TheOnlyMiki/CSEE-4840-N-Body/Software/accelerator_driver.c

/*
 * N-body Avalon-MM Linux driver.
 *
 * This follows nbody_accel_avmm.sv exactly. Register addresses below are
 * byte offsets for ioread32/iowrite32; the hardware Avalon address is a
 * 32-bit word address, so every register is word_address * 4.
 */

#include <linux/errno.h>
#include <linux/fs.h>
#include <linux/init.h>
#include <linux/io.h>
#include <linux/kernel.h>
#include <linux/miscdevice.h>
#include <linux/module.h>
#include <linux/of.h>
#include <linux/of_address.h>
#include <linux/platform_device.h>
#include <linux/slab.h>
#include <linux/string.h>
#include <linux/uaccess.h>
#include "nbody_ioctl.h"

#define DRIVER_NAME "nbody"

#define REG_GO        (0x00 * 4)
#define REG_N_BODIES  (0x01 * 4)
#define REG_GAP       (0x02 * 4)
#define REG_X_IN      (0x03 * 4)
#define REG_Y_IN      (0x04 * 4)
#define REG_M_IN      (0x05 * 4)
#define REG_VX_IN     (0x06 * 4)
#define REG_VY_IN     (0x07 * 4)
#define REG_DONE      (0x08 * 4)
#define REG_READ      (0x09 * 4)
#define REG_OUT_X     (0x0A * 4)
#define REG_OUT_Y     (0x0B * 4)

struct nbody_dev {
    struct resource res;
    void __iomem *virtbase;
    uint32_t num_bodies;
    uint32_t gap;
};

static struct nbody_dev dev;

/*
 * Convert a userspace IEEE-754 single-precision float into the accelerator's
 * custom S1E8M18 27-bit floating-point format.
 *
 * The converted value is stored in the lower 27 bits of a 32-bit Avalon word.
 * The upper 5 bits are unused padding.
 */
static uint32_t f32_to_f27_bits(const float *value)
{
    uint32_t bits;
    uint32_t sign;
    uint32_t exp;
    uint32_t mant;
    uint32_t rounded_mant;

    memcpy(&bits, value, sizeof(bits));

    sign = (bits >> 31) & 1u;
    exp = (bits >> 23) & 0xffu;
    mant = bits & 0x007fffffu;

    if (exp == 0)
        return 0;
    if (exp == 0xffu)
        return (sign << NBODY_F27_SIGN_SHIFT) | (0xfeu << NBODY_F27_EXP_SHIFT) |
               NBODY_F27_MANT_MASK;

    rounded_mant = (mant + 0x10u) >> 5;
    if (rounded_mant == (1u << 18)) {
        rounded_mant = 0;
        exp++;
        if (exp >= 0xffu) {
            exp = 0xfeu;
            rounded_mant = NBODY_F27_MANT_MASK;
        }
    }

    return (sign << NBODY_F27_SIGN_SHIFT) |
           (exp << NBODY_F27_EXP_SHIFT) |
           (rounded_mant & NBODY_F27_MANT_MASK);
}

/*
 * Convert a raw 27-bit S1E8M18 hardware result back into an IEEE-754
 * single-precision float for userspace.
 */
static void f27_bits_to_f32(uint32_t raw, float *value)
{
    uint32_t bits;
    uint32_t sign;
    uint32_t exp;
    uint32_t mant;

    raw &= NBODY_DATA_MASK;
    if (raw == 0) {
        bits = 0;
    } else {
        sign = (raw >> NBODY_F27_SIGN_SHIFT) & 1u;
        exp = (raw >> NBODY_F27_EXP_SHIFT) & 0xffu;
        mant = raw & NBODY_F27_MANT_MASK;

        if (exp == 0) {
            bits = 0;
        } else {
            bits = (sign << 31) | (exp << 23) | (mant << 5);
        }
    }

    memcpy(value, &bits, sizeof(bits));
}

/*
 * Copy the initial particle array from userspace, convert each field from
 * float32 to S1E8M18, and stream the data into the hardware input registers.
 *
 * The hardware commits one complete body when VY_IN is written, so the fields
 * must be written in the expected X, Y, mass, VX, VY order.
 */
static int nbody_write_bodies(unsigned long arg)
{
    nbody_bodies_arg_t barg;
    nbody_particle_t *particles;
    size_t bytes;
    uint32_t i;

    if (copy_from_user(&barg, (void __user *)arg, sizeof(barg)))
        return -EFAULT;

    if (barg.count == 0 || barg.count > NBODY_MAX_BODIES || !barg.particles)
        return -EINVAL;

    if (dev.num_bodies == 0 || barg.count != dev.num_bodies)
        return -EINVAL;

    bytes = barg.count * sizeof(*particles);
    particles = memdup_user((const void __user *)barg.particles, bytes);
    if (IS_ERR(particles))
        return PTR_ERR(particles);

    /*
     * Userspace passes IEEE-754 single-precision values. Hardware payloads are
     * rounded to S1E8M18 in the low 27 bits of each 32-bit Avalon word; the
     * upper 5 bits are zero padding. Writing VY_IN commits the current body
     * and advances input_ptr.
     */
    for (i = 0; i < barg.count; i++) {
        iowrite32(f32_to_f27_bits(&particles[i].x), dev.virtbase + REG_X_IN);
        iowrite32(f32_to_f27_bits(&particles[i].y), dev.virtbase + REG_Y_IN);
        iowrite32(f32_to_f27_bits(&particles[i].mass), dev.virtbase + REG_M_IN);
        iowrite32(f32_to_f27_bits(&particles[i].vx), dev.virtbase + REG_VX_IN);
        iowrite32(f32_to_f27_bits(&particles[i].vy), dev.virtbase + REG_VY_IN);
    }

    kfree(particles);
    return 0;
}

/*
 * Read computed body positions from the accelerator output registers.
 *
 * Writing READ=1 prepares the hardware output stream. For each body, OUT_X is
 * read first and OUT_Y is read second. The hardware output pointer advances
 * only after OUT_Y is read.
 */
static int nbody_read_results(unsigned long arg)
{
    nbody_read_arg_t rarg;
    nbody_result_t *results;
    size_t bytes;
    uint32_t i;
    int ret = 0;

    if (copy_from_user(&rarg, (void __user *)arg, sizeof(rarg)))
        return -EFAULT;

    if (rarg.count == 0 || rarg.count > NBODY_MAX_BODIES ||
        rarg.count > dev.num_bodies || !rarg.results)
        return -EINVAL;

    bytes = rarg.count * sizeof(*results);
    results = kmalloc(bytes, GFP_KERNEL);
    if (!results)
        return -ENOMEM;

    iowrite32(1, dev.virtbase + REG_READ);

    /*
     * Read OUT_X first, then OUT_Y. Only the OUT_Y read increments the
     * hardware output pointer.
     */
    for (i = 0; i < rarg.count; i++) {
        f27_bits_to_f32(ioread32(dev.virtbase + REG_OUT_X), &results[i].x);
        f27_bits_to_f32(ioread32(dev.virtbase + REG_OUT_Y), &results[i].y);
    }

    if (copy_to_user((void __user *)rarg.results, results, bytes))
        ret = -EFAULT;

    kfree(results);
    return ret;
}

/*
 * Main ioctl dispatch function for /dev/nbody.
 *
 * Each command corresponds to one userspace accelerator operation, such as
 * writing configuration, loading input bodies, starting a run, checking DONE,
 * reading output positions, or clearing the hardware read state.
 */
static long nbody_ioctl(struct file *f, unsigned int cmd, unsigned long arg)
{
    nbody_config_t cfg;
    int done;

    switch (cmd) {
    case NBODY_WRITE_CONFIG:
        if (copy_from_user(&cfg, (void __user *)arg, sizeof(cfg)))
            return -EFAULT;
        if (cfg.num_bodies > NBODY_MAX_BODIES || cfg.gap == 0)
            return -EINVAL;

        dev.num_bodies = cfg.num_bodies;
        dev.gap = cfg.gap;
        iowrite32(cfg.num_bodies, dev.virtbase + REG_N_BODIES);
        iowrite32(cfg.gap, dev.virtbase + REG_GAP);
        return 0;

    case NBODY_WRITE_BODIES:
        return nbody_write_bodies(arg);

    case NBODY_START_RUN:
        iowrite32(1, dev.virtbase + REG_GO);
        return 0;

    case NBODY_CHECK_DONE:
        done = ioread32(dev.virtbase + REG_DONE) & 1;
        if (copy_to_user((int __user *)arg, &done, sizeof(done)))
            return -EFAULT;
        return 0;

    case NBODY_READ_RESULTS:
        return nbody_read_results(arg);

    case NBODY_CLEAR_READ:
        iowrite32(0, dev.virtbase + REG_READ);
        return 0;

    case NBODY_STOP:
        /* GO is pulse-based in SV; best-effort stop is clearing READ. */
        iowrite32(0, dev.virtbase + REG_READ);
        return 0;

    case NBODY_SOFT_RESET:
        /*
         * There is no full software reset register. Clear READ/output_ptr;
         * userspace must reload config and bodies for a fresh simulation.
         */
        iowrite32(0, dev.virtbase + REG_READ);
        return 0;

    default:
        return -EINVAL;
    }
}

static const struct file_operations nbody_fops = {
    .owner = THIS_MODULE,
    .unlocked_ioctl = nbody_ioctl,
};

static struct miscdevice nbody_misc_device = {
    .minor = MISC_DYNAMIC_MINOR,
    .name = "nbody",
    .fops = &nbody_fops,
};

/*
 * Platform driver probe function.
 *
 * This function is called when the matching device-tree node is found. It maps
 * the accelerator register space, registers /dev/nbody as a misc device, and
 * initializes basic hardware control registers.
 */
static int nbody_probe(struct platform_device *pdev)
{
    int ret;

    ret = of_address_to_resource(pdev->dev.of_node, 0, &dev.res);
    if (ret)
        return ret;

    if (!request_mem_region(dev.res.start, resource_size(&dev.res), DRIVER_NAME))
        return -EBUSY;

    dev.virtbase = of_iomap(pdev->dev.of_node, 0);
    if (!dev.virtbase) {
        ret = -ENOMEM;
        goto out_release;
    }

    ret = misc_register(&nbody_misc_device);
    if (ret)
        goto out_unmap;

    iowrite32(0, dev.virtbase + REG_READ);
    iowrite32(1, dev.virtbase + REG_GAP);
    pr_info("nbody driver registered /dev/nbody\n");
    return 0;

out_unmap:
    iounmap(dev.virtbase);
out_release:
    release_mem_region(dev.res.start, resource_size(&dev.res));
    return ret;
}

/*
 * Platform driver remove function.
 *
 * Release the misc device, unmap the hardware register space, and free the
 * reserved memory region.
 */
static int nbody_remove(struct platform_device *pdev)
{
    misc_deregister(&nbody_misc_device);
    if (dev.virtbase)
        iounmap(dev.virtbase);
    release_mem_region(dev.res.start, resource_size(&dev.res));
    return 0;
}

static const struct of_device_id nbody_of_match[] = {
    { .compatible = "csee4840,nbody_accel_avmm-1.0" },
    {},
};
MODULE_DEVICE_TABLE(of, nbody_of_match);

static struct platform_driver nbody_driver = {
    .probe = nbody_probe,
    .remove = nbody_remove,
    .driver = {
        .name = DRIVER_NAME,
        .of_match_table = nbody_of_match,
    },
};

module_platform_driver(nbody_driver);

MODULE_LICENSE("GPL");
MODULE_AUTHOR("CSEE4840 Group");
MODULE_DESCRIPTION("N-body Avalon-MM accelerator driver");
