TheOnlyMiki/CSEE-4840-N-Body/Software/display.c

#include <ctype.h>
#include <fcntl.h>
#include <stdint.h>
#include <stdio.h>
#include <stdlib.h>
#include <string.h>
#include <sys/ioctl.h>
#include <unistd.h>

#include "display.h"
#include "nbody.h"

static int display_fd = -1;
static uint32_t framebuffer[DISPLAY_WORDS];
static uint8_t body_masks[NUM_BODY_RADII][9][9];

static const int BODY_RADII[NUM_BODY_RADII] = { 1, 2, 3, 4 };

// Set a specific pixel is on or off (1/0)
static inline void set_pixel(int x, int y, int on)
{
    // Check if the coordinates are out of bounds
    if (x < 0 || x >= DISPLAY_WIDTH || y < 0 || y >= DISPLAY_HEIGHT)
        return;

    /*
    Packed display format
    frame index = y * 20 + x / 32, bit = x & 31 (x % 32)
    one LSB-first bit per pixel
    */
    if (on) {
        framebuffer[y * DISPLAY_WORDS_PER_ROW + x / 32] |= (1u << (x & 31));
    } else {
        framebuffer[y * DISPLAY_WORDS_PER_ROW + x / 32] &= ~(1u << (x & 31));
    }
}

// Returning the 5-bit character set of a given character in a given line
static uint8_t glyph_row(char c, int row)
{
    // Each character consists of 7 rows, with each row represented by 5 bits
    static const uint8_t blank[7] = { 0, 0, 0, 0, 0, 0, 0 };
    static const uint8_t glyphs[][7] = {
        ['0'] = { 0x0e, 0x11, 0x13, 0x15, 0x19, 0x11, 0x0e },
        ['1'] = { 0x04, 0x0c, 0x04, 0x04, 0x04, 0x04, 0x0e },
        ['2'] = { 0x0e, 0x11, 0x01, 0x02, 0x04, 0x08, 0x1f },
        ['3'] = { 0x1e, 0x01, 0x01, 0x0e, 0x01, 0x01, 0x1e },
        ['4'] = { 0x02, 0x06, 0x0a, 0x12, 0x1f, 0x02, 0x02 },
        ['5'] = { 0x1f, 0x10, 0x10, 0x1e, 0x01, 0x01, 0x1e },
        ['6'] = { 0x0e, 0x10, 0x10, 0x1e, 0x11, 0x11, 0x0e },
        ['7'] = { 0x1f, 0x01, 0x02, 0x04, 0x08, 0x08, 0x08 },
        ['8'] = { 0x0e, 0x11, 0x11, 0x0e, 0x11, 0x11, 0x0e },
        ['9'] = { 0x0e, 0x11, 0x11, 0x0f, 0x01, 0x01, 0x0e },
        ['A'] = { 0x0e, 0x11, 0x11, 0x1f, 0x11, 0x11, 0x11 },
        ['B'] = { 0x1e, 0x11, 0x11, 0x1e, 0x11, 0x11, 0x1e },
        ['C'] = { 0x0f, 0x10, 0x10, 0x10, 0x10, 0x10, 0x0f },
        ['D'] = { 0x1e, 0x11, 0x11, 0x11, 0x11, 0x11, 0x1e },
        ['E'] = { 0x1f, 0x10, 0x10, 0x1e, 0x10, 0x10, 0x1f },
        ['F'] = { 0x1f, 0x10, 0x10, 0x1e, 0x10, 0x10, 0x10 },
        ['G'] = { 0x0f, 0x10, 0x10, 0x13, 0x11, 0x11, 0x0f },
        ['H'] = { 0x11, 0x11, 0x11, 0x1f, 0x11, 0x11, 0x11 },
        ['I'] = { 0x0e, 0x04, 0x04, 0x04, 0x04, 0x04, 0x0e },
        ['J'] = { 0x07, 0x02, 0x02, 0x02, 0x12, 0x12, 0x0c },
        ['K'] = { 0x11, 0x12, 0x14, 0x18, 0x14, 0x12, 0x11 },
        ['L'] = { 0x10, 0x10, 0x10, 0x10, 0x10, 0x10, 0x1f },
        ['M'] = { 0x11, 0x1b, 0x15, 0x15, 0x11, 0x11, 0x11 },
        ['N'] = { 0x11, 0x19, 0x15, 0x13, 0x11, 0x11, 0x11 },
        ['O'] = { 0x0e, 0x11, 0x11, 0x11, 0x11, 0x11, 0x0e },
        ['P'] = { 0x1e, 0x11, 0x11, 0x1e, 0x10, 0x10, 0x10 },
        ['Q'] = { 0x0e, 0x11, 0x11, 0x11, 0x15, 0x12, 0x0d },
        ['R'] = { 0x1e, 0x11, 0x11, 0x1e, 0x14, 0x12, 0x11 },
        ['S'] = { 0x0f, 0x10, 0x10, 0x0e, 0x01, 0x01, 0x1e },
        ['T'] = { 0x1f, 0x04, 0x04, 0x04, 0x04, 0x04, 0x04 },
        ['U'] = { 0x11, 0x11, 0x11, 0x11, 0x11, 0x11, 0x0e },
        ['V'] = { 0x11, 0x11, 0x11, 0x11, 0x11, 0x0a, 0x04 },
        ['W'] = { 0x11, 0x11, 0x11, 0x15, 0x15, 0x15, 0x0a },
        ['X'] = { 0x11, 0x11, 0x0a, 0x04, 0x0a, 0x11, 0x11 },
        ['Y'] = { 0x11, 0x11, 0x0a, 0x04, 0x04, 0x04, 0x04 },
        ['Z'] = { 0x1f, 0x01, 0x02, 0x04, 0x08, 0x10, 0x1f },
        [':'] = { 0x00, 0x04, 0x04, 0x00, 0x04, 0x04, 0x00 },
        ['/'] = { 0x01, 0x01, 0x02, 0x04, 0x08, 0x10, 0x10 },
        ['['] = { 0x0e, 0x08, 0x08, 0x08, 0x08, 0x08, 0x0e },
        [']'] = { 0x0e, 0x02, 0x02, 0x02, 0x02, 0x02, 0x0e },
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
    };
    const uint8_t *g;

    // Converts lowercase letters to uppercase
    if (c >= 'a' && c <= 'z')
        c = (char)toupper((unsigned char)c);

    // If the character is not supported, display a blank space
    if ((unsigned char) c >= sizeof(glyphs) / sizeof(glyphs[0])) {
        g = blank;
    } else {
        g = glyphs[(unsigned char) c];
    }

    return g[row];
}

// Convert the simulation's world coordinates into screen pixel coordinates
int world_to_screen_x(float x)
{
    float normalized = (x - NBODY_POS_MIN) / (NBODY_POS_MAX - NBODY_POS_MIN);
    return (int) (normalized * (float)(BODY_DISPLAY_W - 1) + 0.5f);
}

// Convert the simulation's world coordinates into screen pixel coordinates
int world_to_screen_y(float y)
{
    float normalized = (y - NBODY_POS_MIN) / (NBODY_POS_MAX - NBODY_POS_MIN);
    return (int) (normalized * (float)(BODY_DISPLAY_H - 1) + 0.5f);
}

// Clear the entire framebuffer to 0, resulting in a black screen
void display_clear(void)
{
    memset(framebuffer, 0, sizeof(framebuffer));
}

/*
The rendering thread needs to draw numerous bodies in every frame
Recalculating the circular geometry each time a body is drawn is time-consuming
Instead, pre-generate the masks beforehand
then simply perform a direct lookup when rendering
*/
void display_init_bodyshape(void)
{
    memset(body_masks, 0, sizeof(body_masks));

    for (int i = 0; i < NUM_BODY_RADII; i++) {
        int r = BODY_RADII[i];
        for (int y = -r; y <= r; y++)
            for (int x = -r; x <= r; x++)
                if (x * x + y * y < r * r + r)
                    body_masks[i][y + r][x + r] = 1;
    }
}

// Draw a body at position (cx, cy)
void display_draw_body(int cx, int cy, int radius_idx)
{
    int r = BODY_RADII[radius_idx];
    for (int y = -r; y <= r; y++) {
        int sy = cy + y;

        // Check if the coordinates are out of bounds
        if (sy < 0 || sy >= BODY_DISPLAY_H)
            continue;
        for (int x = -r; x <= r; x++)
            if (body_masks[radius_idx][y + r][x + r])
                set_pixel(cx + x, sy, 1);
    }
}

// Draw a character at a specific row and column within a text grid
void display_putchar(char c, int row, int col)
{
    // Check if the coordinates are out of bounds
    if (row < 0 || row >= TEXT_ROWS || col < 0 || col >= TEXT_COLS)
        return;

    // Render 5 x 7 character to 8 × 16 pixels
    for (int y = 0; y < FONT_HEIGHT; y++) {
        uint8_t bits = 0;

        if (y >= 2 && y < 16)
            bits = glyph_row(c, (y - 2) / 2);

        for (int x = 0; x < FONT_WIDTH; x++) {
            int on = (x >= 1 && x <= 5) && (bits & (1u << (5 - x)));
            set_pixel(col * FONT_WIDTH + x, row * FONT_HEIGHT + y, on);
        }
    }
}

// Draw Strings Continuously
void display_puts(const char *s, int row, int col)
{
    while (*s && col < TEXT_COLS) {
        display_putchar(*s++, row, col++);
    }
}

// Send the software framebuffer to the kernel driver
// If /dev/nbody_display is not open, return -1
int display_present(void)
{
    if (display_fd < 0)
        return -1;
    return ioctl(display_fd, DISPLAY_WRITE_FRAME, framebuffer);
}

// Display Thread
void *display_thread(void *arg)
{
    // It is merely there to avoid a compiler warning
    (void) arg;

    // Allocate a temporary array to store the positions of the current frame
    body_pos_t *render_positions = malloc(MAX_BODIES * sizeof(*render_positions));
    if (!render_positions)
        return NULL;

    // Open display device
    display_fd = open("/dev/nbody_display", O_RDWR);
    if (display_fd < 0)
        perror("open /dev/nbody_display");

    // Initialize circular mask for the body
    display_init_bodyshape();

    while (running) {
        // Copy a local variables from the global variables
        pthread_mutex_lock(&state_mutex);
        int local_num = num_bodies;
        int local_gap = current_gap;
        int local_count = h_count;
        int local_view = view_idx;
        int local_paused = is_paused;

        // Select the current frame to be displayed from history frames
        if (local_count > 0) {
            int slot = (local_count < MAX_HISTORY) ? local_view : (h_head + local_view) & (MAX_HISTORY - 1);
            memcpy(render_positions, history[slot], local_num * sizeof(*render_positions));
        }
        pthread_mutex_unlock(&state_mutex);

        // Clear the display framebuffer
        display_clear();

        // If historical frames exist
        if (local_count > 0) {
            for (int i = 0; i < local_num; i++) {
                // Retrieve world x/y coordinates and convert to screen x/y coordinates
                int x = world_to_screen_x(render_positions[i].x);
                int y = world_to_screen_y(render_positions[i].y);
                display_draw_body(x, y, (int)static_masses[i]);
            }
        }

        // Display the UI in last two rows in screen/VGA
        char line1[TEXT_COLS + 1];
        snprintf(line1, sizeof(line1), "Bodies: %4d/%d | Gap: %2d/%d | Frame: %d/%d | Status: %s",
                 local_num, MAX_BODIES, local_gap, NBODY_GAP_MAX, local_view + 1, local_count,
                 local_paused ? "PAUSED" : "RUNNING");
        display_puts(line1, UI_START_ROW, 0);
        display_puts("[SPACE] Play/Pause | [W/S] Gap | [A/D] Frame | [R] Reset | [Q] Exit",
                     UI_START_ROW + 1, 0);
        
        // Write the entire framebuffer to the display hardware
        display_present();

        // It sleeps for 33.333 ms, the display thread is running at approximately 30 fps
        usleep(33333);
    }

    // Clear the screen once before exiting and close the display device
    if (display_fd >= 0) {
        display_clear();
        display_present();
        close(display_fd);
        display_fd = -1;
    }

    // Release temporary array
    free(render_positions);

    return NULL;
}
