TheOnlyMiki/CSEE-4840-N-Body/Hardware/tb/tb_core_accel.sv

`timescale 1ns/1ps

//------------------------------------------------------------------------------
// TB: multi-body streaming scheduler driving a 2-body core
// - Reads frame0 file:  idx px py vx vy m   (all hex, S1E8M18 for px/py/vx/vy/m)
// - Streams all pairs (b1 accumulates contributions from every b2!=b1)
// - Core interface:
//     inputs: 27-bit S1E8M18 (pos/mass), prev accel: 27-bit S1E8M18
//     outputs: 27-bit S1E8M18
// - Core has fixed epsilon_square internally 

module tb_core_accel;

  // -----------------------------
  // User knobs
  // -----------------------------
  localparam int N_BODIES  = 1024;   // <-- set any N you want
  localparam int PIPE_LAT  = 18;
  parameter  int PREV_LAT  = 16;

  localparam string INPUT_FILE = "tb/frame_input/frame0_1024binit200_27bits.txt";
  localparam string OUT_FILE_27bits = "tb/output/eps025_accel_27bits_1024binit200.txt";

  logic        i_clk;
  logic        i_rst;  // active-low reset

  logic [26:0] i_b1_x, i_b1_y;
  logic [26:0] i_b2_x, i_b2_y;
  logic [26:0] i_m_b2;

  wire  [26:0] i_a_b1_x, i_a_b1_y;       // 27-bit prev accel, late-aligned
  wire  [26:0] o_a_b1_x, o_a_b1_y;       // 27-bit DUT accel out

  two_body_core dut (
    .i_clk    (i_clk),
    .i_rst    (i_rst),

    .i_b1_x   (i_b1_x),
    .i_b1_y   (i_b1_y),
    .i_b2_x   (i_b2_x),
    .i_b2_y   (i_b2_y),
    .i_m_b2   (i_m_b2),

    .i_a_b1_x (i_a_b1_x),
    .i_a_b1_y (i_a_b1_y),

    .o_a_b1_x (o_a_b1_x),
    .o_a_b1_y (o_a_b1_y)
  );

  // Clock
  initial i_clk = 1'b0;
  always #5 i_clk = ~i_clk; // 100MHz

  // Frame storage
  logic [26:0] px [0:N_BODIES-1];
  logic [26:0] py [0:N_BODIES-1];
  logic [26:0] m  [0:N_BODIES-1];



  // Streaming control
  logic in_valid;
  logic [PIPE_LAT-1:0] vsh;
  logic out_valid;
  assign out_valid = vsh[PIPE_LAT-1];

  logic [26:0] launch_prev_x_27, launch_prev_y_27;
  logic [26:0] prev_x_pipe [0:PREV_LAT-1];
  logic [26:0] prev_y_pipe [0:PREV_LAT-1];

  always_ff @(posedge i_clk) begin
    if (!i_rst) begin
      vsh <= '0;
      for (int p = 0; p < PREV_LAT; p++) begin
        prev_x_pipe[p] <= 27'd0;
        prev_y_pipe[p] <= 27'd0;
      end
    end else begin
      vsh <= {vsh[PIPE_LAT-2:0], in_valid};

      prev_x_pipe[0] <= in_valid ? launch_prev_x_27 : 27'd0;
      prev_y_pipe[0] <= in_valid ? launch_prev_y_27 : 27'd0;
      for (int p = 0; p < PREV_LAT-1; p++) begin
        prev_x_pipe[p+1] <= prev_x_pipe[p];
        prev_y_pipe[p+1] <= prev_y_pipe[p];
      end
    end
  end

  assign i_a_b1_x = prev_x_pipe[PREV_LAT-1];
  assign i_a_b1_y = prev_y_pipe[PREV_LAT-1];

  // Helper tasks for driving input and reading frame files
  task automatic drive_idle();
    begin
      i_b1_x   <= 27'h1FC0000;
      i_b1_y   <= 27'h0000000;
      i_b2_x   <= 27'h2000000;
      i_b2_y   <= 27'h0000000;
      i_m_b2   <= 27'h1FC0000;

      launch_prev_x_27 <= 27'd0;
      launch_prev_y_27 <= 27'd0;

      in_valid <= 1'b0;
    end
  endtask

  // Helper task to drive one transaction (one pair of bodies, plus prev accel)
  task automatic drive_txn(
    input int b1,
    input int b2,
    input logic [26:0] a_prev_x_27,
    input logic [26:0] a_prev_y_27
  );
    begin
      i_b1_x   <= px[b1];
      i_b1_y   <= py[b1];
      i_b2_x   <= px[b2];
      i_b2_y   <= py[b2];
      i_m_b2   <= m[b2];

      launch_prev_x_27 <= a_prev_x_27;
      launch_prev_y_27 <= a_prev_y_27;

      in_valid <= 1'b1;
    end
  endtask

  // Read input frame file
  // line format: idx px py vx vy m (hex)
  task automatic read_frame_file(input string fname);
    int fd;
    string line;
    int idx;
    logic [26:0] lpx, lpy, lvx, lvy, lm;
    int got;
    begin
      for (int t = 0; t < N_BODIES; t++) begin
        px[t] = 27'h0000000;
        py[t] = 27'h0000000;
        m[t]  = 27'h0000000;
      end

      fd = $fopen(fname, "r");
      if (fd == 0) $fatal(1, "ERROR: cannot open INPUT_FILE=%s", fname);

      while (!$feof(fd)) begin
        line = "";
        void'($fgets(line, fd));

        if (line.len() == 0) continue;
        if (line.substr(0,0) == "#") continue;

        got = $sscanf(line, "%d %h %h %h %h %h",
                      idx, lpx, lpy, lvx, lvy, lm);

        if (got == 6 && idx >= 0 && idx < N_BODIES) begin
          px[idx] = lpx;
          py[idx] = lpy;
          m[idx]  = lm;
        end
      end
      $fclose(fd);
    end
  endtask

  // Auto-alignment queue (tracks which txn produced each output)
  typedef struct packed {
    int b1;
    int b2;
  } txn_t;

  txn_t q[$];

  // Scheduling state
  // We keep per-b1 running accel in 27-bit (as the core output is "prev+term")
  // busy[b1] prevents issuing next (b1, b2) until previous output for b1 returns.
  logic [26:0] a_acc_x_27 [0:N_BODIES-1];
  logic [26:0] a_acc_y_27 [0:N_BODIES-1];
  logic        busy       [0:N_BODIES-1];
  int          next_j     [0:N_BODIES-1];

  function automatic int pick_b1();
    int b;
    begin
      pick_b1 = -1;
      for (b = 0; b < N_BODIES; b++) begin
        if (!busy[b]) begin
          // skip self-pair
          while (next_j[b] < N_BODIES && next_j[b] == b) next_j[b]++;
          if (next_j[b] < N_BODIES) begin
            pick_b1 = b;
            return pick_b1;
          end
        end
      end
    end
  endfunction

  function automatic bit all_done();
    int b;
    begin
      all_done = 1'b1;
      for (b = 0; b < N_BODIES; b++) begin
        int tmp;
        tmp = next_j[b];
        while (tmp < N_BODIES && tmp == b) tmp++;
        if (tmp < N_BODIES) all_done = 1'b0;
        if (busy[b])        all_done = 1'b0;
      end
      if (q.size() != 0) all_done = 1'b0;
      if (vsh != '0)     all_done = 1'b0;
    end
  endfunction

  integer fo;
  integer b;
  integer b1;
  integer b2;

  initial begin
    drive_idle();

    // reset (active-low)
    i_rst = 1'b0;
    repeat (5) @(posedge i_clk);
    i_rst = 1'b1;
    repeat (5) @(posedge i_clk);

    read_frame_file(INPUT_FILE);

    // init per-body accumulators and sched
    for (b = 0; b < N_BODIES; b++) begin
      a_acc_x_27[b] = 27'd0;
      a_acc_y_27[b] = 27'd0;
      busy[b]       = 1'b0;
      next_j[b]     = 0;
    end

    // streaming loop
    while (!all_done()) begin
      @(posedge i_clk); #1;

      // 1) receive aligned output (27-bit), update per-b1 accumulator
      if (out_valid) begin
        txn_t t;
        if (q.size() == 0) $fatal(1, "out_valid but txn queue empty (alignment bug)");
        t = q.pop_front();

        // core returns prev+term already, so we overwrite accumulator
        a_acc_x_27[t.b1] = o_a_b1_x;
        a_acc_y_27[t.b1] = o_a_b1_y;

        busy[t.b1] = 1'b0;
      end

      // 2) issue one txn if possible
      b1 = pick_b1();
      if (b1 >= 0) begin
        b2 = next_j[b1];
        while (b2 < N_BODIES && b2 == b1) b2++;

        if (b2 < N_BODIES) begin
          drive_txn(b1, b2, a_acc_x_27[b1], a_acc_y_27[b1]);

          q.push_back('{b1:b1, b2:b2});

          busy[b1]   = 1'b1;
          next_j[b1] = b2 + 1;
        end else begin
          drive_idle();
        end
      end else begin
        drive_idle();
      end
    end

    // write 27-bit accumulated output
    fo = $fopen(OUT_FILE_27bits, "w");
    if (fo == 0) $fatal(1, "ERROR: cannot open OUT_FILE_27bits=%s", OUT_FILE_27bits);
    $fwrite(fo, "# i ax27 ay27 (S1E8M18 hex)\n");
    for (b = 0; b < N_BODIES; b++) begin
      $fwrite(fo, "%4d  %07h  %07h\n", b, a_acc_x_27[b], a_acc_y_27[b]);
    end
    $fclose(fo);

    $display("DONE. Wrote %s", OUT_FILE_27bits);
    $finish;
  end

endmodule
