TheOnlyMiki/CSEE-4840-N-Body/Hardware/code/four_core_wrapper.sv

module four_core_wrapper #(
    parameter int DATA_W = 27
) (
    input  logic        i_clk,
    input  logic        i_rst,   // active-low synchronous reset

    // external phase control
    input  logic        i_clear_prev,
    input  logic        i_load_en,
    input  logic        i_compute_en,

    // load 16 i-bodies into local wrapper memory
    input  logic [3:0]  i_load_idx,
    input  logic [DATA_W-1:0] i_load_x,
    input  logic [DATA_W-1:0] i_load_y,

    // external group select: combinationally selects which 4 i-bodies feed the datapath
    // or which cached 4-lane result group is read out
    input  logic [1:0]  i_grp_sel,

    // broadcasted j input
    input  logic [DATA_W-1:0] i_j_x,
    input  logic [DATA_W-1:0] i_j_y,
    input  logic [DATA_W-1:0] i_j_m,
    input  logic [3:0]  i_lane_mask,

    // accumulated outputs
    output logic [DATA_W-1:0] o_res0_x,
    output logic [DATA_W-1:0] o_res0_y,
    output logic [DATA_W-1:0] o_res1_x,
    output logic [DATA_W-1:0] o_res1_y,
    output logic [DATA_W-1:0] o_res2_x,
    output logic [DATA_W-1:0] o_res2_y,
    output logic [DATA_W-1:0] o_res3_x,
    output logic [DATA_W-1:0] o_res3_y,

    // selected group results valid
    output logic        o_res_vld
);

    localparam int PIPE_LAT = 18;
    integer i;

    // local i-body memory (16 entries)
    logic [DATA_W-1:0] i_x_mem [16];
    logic [DATA_W-1:0] i_y_mem [16];

    // internal cached accumulated outputs (real wrapper outputs)
    logic [DATA_W-1:0] acc_x_bank [16];
    logic [DATA_W-1:0] acc_y_bank [16];
    logic [3:0]  grp_written;

    // fixed feedback chain (no per-group selection here)
    logic [DATA_W-1:0] prev0_x_d0, prev0_x_d1, prev0_y_d0, prev0_y_d1;
    logic [DATA_W-1:0] prev1_x_d0, prev1_x_d1, prev1_y_d0, prev1_y_d1;
    logic [DATA_W-1:0] prev2_x_d0, prev2_x_d1, prev2_y_d0, prev2_y_d1;
    logic [DATA_W-1:0] prev3_x_d0, prev3_x_d1, prev3_y_d0, prev3_y_d1;

    // c0->c17 pipelined delay for writeback address alignment
    logic       vld_pipe [PIPE_LAT];
    logic [1:0] grp_pipe [PIPE_LAT];

    // current group selection for datapath/readout
    logic [3:0] grp_base;
    logic [3:0] wb_base;

    assign grp_base = {i_grp_sel, 2'b00};
    assign wb_base  = {grp_pipe[PIPE_LAT-1], 2'b00};

    logic [DATA_W-1:0] cur_i0_x;
    logic [DATA_W-1:0] cur_i0_y;
    logic [DATA_W-1:0] cur_i1_x;
    logic [DATA_W-1:0] cur_i1_y;
    logic [DATA_W-1:0] cur_i2_x;
    logic [DATA_W-1:0] cur_i2_y;
    logic [DATA_W-1:0] cur_i3_x;
    logic [DATA_W-1:0] cur_i3_y;

    assign cur_i0_x = i_x_mem[grp_base + 4'd0];
    assign cur_i0_y = i_y_mem[grp_base + 4'd0];
    assign cur_i1_x = i_x_mem[grp_base + 4'd1];
    assign cur_i1_y = i_y_mem[grp_base + 4'd1];
    assign cur_i2_x = i_x_mem[grp_base + 4'd2];
    assign cur_i2_y = i_y_mem[grp_base + 4'd2];
    assign cur_i3_x = i_x_mem[grp_base + 4'd3];
    assign cur_i3_y = i_y_mem[grp_base + 4'd3];

    // active-high mask: 1 => self/invalid/hold, so new term is nulled by mj=0
    logic [DATA_W-1:0] j0_m_eff;
    logic [DATA_W-1:0] j1_m_eff;
    logic [DATA_W-1:0] j2_m_eff;
    logic [DATA_W-1:0] j3_m_eff;

    assign j0_m_eff = i_lane_mask[0] ? '0 : i_j_m;
    assign j1_m_eff = i_lane_mask[1] ? '0 : i_j_m;
    assign j2_m_eff = i_lane_mask[2] ? '0 : i_j_m;
    assign j3_m_eff = i_lane_mask[3] ? '0 : i_j_m;

    // outputs of datapath instances
    logic [DATA_W-1:0] dp_out0_x, dp_out0_y;
    logic [DATA_W-1:0] dp_out1_x, dp_out1_y;
    logic [DATA_W-1:0] dp_out2_x, dp_out2_y;
    logic [DATA_W-1:0] dp_out3_x, dp_out3_y;

    fourcore_bcj_datapath #(
        .DATA_W(DATA_W)
    ) u_dp (
        .i_clk    (i_clk),
        .i_rst    (i_rst),
        .i_j_x    (i_compute_en ? i_j_x    : '0),
        .i_j_y    (i_compute_en ? i_j_y    : '0),
        .i_j0_m   (i_compute_en ? j0_m_eff : '0),
        .i_j1_m   (i_compute_en ? j1_m_eff : '0),
        .i_j2_m   (i_compute_en ? j2_m_eff : '0),
        .i_j3_m   (i_compute_en ? j3_m_eff : '0),
        .i_i0_x   (i_compute_en ? cur_i0_x : '0),
        .i_i0_y   (i_compute_en ? cur_i0_y : '0),
        .i_prev0_x(prev0_x_d1),
        .i_prev0_y(prev0_y_d1),
        .o_out0_x (dp_out0_x),
        .o_out0_y (dp_out0_y),
        .i_i1_x   (i_compute_en ? cur_i1_x : '0),
        .i_i1_y   (i_compute_en ? cur_i1_y : '0),
        .i_prev1_x(prev1_x_d1),
        .i_prev1_y(prev1_y_d1),
        .o_out1_x (dp_out1_x),
        .o_out1_y (dp_out1_y),
        .i_i2_x   (i_compute_en ? cur_i2_x : '0),
        .i_i2_y   (i_compute_en ? cur_i2_y : '0),
        .i_prev2_x(prev2_x_d1),
        .i_prev2_y(prev2_y_d1),
        .o_out2_x (dp_out2_x),
        .o_out2_y (dp_out2_y),
        .i_i3_x   (i_compute_en ? cur_i3_x : '0),
        .i_i3_y   (i_compute_en ? cur_i3_y : '0),
        .i_prev3_x(prev3_x_d1),
        .i_prev3_y(prev3_y_d1),
        .o_out3_x (dp_out3_x),
        .o_out3_y (dp_out3_y)
    );

    task automatic clear_wrapper_state;
        for (i = 0; i < 16; i = i + 1) begin
            acc_x_bank[i] <= '0;
            acc_y_bank[i] <= '0;
        end

        grp_written <= 4'b0000;

        prev0_x_d0 <= '0; prev0_x_d1 <= '0; prev0_y_d0 <= '0; prev0_y_d1 <= '0;
        prev1_x_d0 <= '0; prev1_x_d1 <= '0; prev1_y_d0 <= '0; prev1_y_d1 <= '0;
        prev2_x_d0 <= '0; prev2_x_d1 <= '0; prev2_y_d0 <= '0; prev2_y_d1 <= '0;
        prev3_x_d0 <= '0; prev3_x_d1 <= '0; prev3_y_d0 <= '0; prev3_y_d1 <= '0;

        for (i = 0; i < PIPE_LAT; i = i + 1) begin
            vld_pipe[i] <= 1'b0;
            grp_pipe[i] <= 2'd0;
        end
    endtask

    // sequential state updates
    always_ff @(posedge i_clk) begin
        if (!i_rst) begin
            for (i = 0; i < 16; i = i + 1) begin
                i_x_mem[i] <= '0;
                i_y_mem[i] <= '0;
            end

            clear_wrapper_state();
        end else if (i_load_en) begin
            // load current i entry
            i_x_mem[i_load_idx] <= i_load_x;
            i_y_mem[i_load_idx] <= i_load_y;

            // clear wrapper-side cached outputs / feedback / metadata
            // during tile load so no stale values pollute the next compute phase.
            clear_wrapper_state();
        end else if (i_clear_prev) begin
            // explicit clear between phases / after sufficient drain
            clear_wrapper_state();
        end else begin
            // fixed feedback transport
            prev0_x_d1 <= prev0_x_d0; prev0_y_d1 <= prev0_y_d0; prev0_x_d0 <= dp_out0_x; prev0_y_d0 <= dp_out0_y;
            prev1_x_d1 <= prev1_x_d0; prev1_y_d1 <= prev1_y_d0; prev1_x_d0 <= dp_out1_x; prev1_y_d0 <= dp_out1_y;
            prev2_x_d1 <= prev2_x_d0; prev2_y_d1 <= prev2_y_d0; prev2_x_d0 <= dp_out2_x; prev2_y_d0 <= dp_out2_y;
            prev3_x_d1 <= prev3_x_d0; prev3_y_d1 <= prev3_y_d0; prev3_x_d0 <= dp_out3_x; prev3_y_d0 <= dp_out3_y;

            // sample current external group as the true c0 group when this issue enters core
            vld_pipe[0] <= i_compute_en;
            grp_pipe[0] <= i_grp_sel;
            for (int i = 0; i < PIPE_LAT-1; i++) begin
                vld_pipe[i+1] <= vld_pipe[i];
                grp_pipe[i+1] <= grp_pipe[i];
            end

            // c17-aligned out_mem writeback (wrapper result storage)
            if (vld_pipe[PIPE_LAT-1]) begin
                acc_x_bank[wb_base + 4'd0] <= dp_out0_x;
                acc_y_bank[wb_base + 4'd0] <= dp_out0_y;
                acc_x_bank[wb_base + 4'd1] <= dp_out1_x;
                acc_y_bank[wb_base + 4'd1] <= dp_out1_y;
                acc_x_bank[wb_base + 4'd2] <= dp_out2_x;
                acc_y_bank[wb_base + 4'd2] <= dp_out2_y;
                acc_x_bank[wb_base + 4'd3] <= dp_out3_x;
                acc_y_bank[wb_base + 4'd3] <= dp_out3_y;
                grp_written[grp_pipe[PIPE_LAT-1]] <= 1'b1;
            end
        end
    end

    // real output is always selected from out_mem, using the same single grp_sel
    assign o_res0_x = acc_x_bank[grp_base + 4'd0];
    assign o_res0_y = acc_y_bank[grp_base + 4'd0];
    assign o_res1_x = acc_x_bank[grp_base + 4'd1];
    assign o_res1_y = acc_y_bank[grp_base + 4'd1];
    assign o_res2_x = acc_x_bank[grp_base + 4'd2];
    assign o_res2_y = acc_y_bank[grp_base + 4'd2];
    assign o_res3_x = acc_x_bank[grp_base + 4'd3];
    assign o_res3_y = acc_y_bank[grp_base + 4'd3];
    assign o_res_vld = grp_written[i_grp_sel];

endmodule
