TheOnlyMiki/CSEE-4840-N-Body/Hardware/code/FpAdd.sv

/**************************************************************************
 * Floating Point Adder                                                   *
 * 2-stage pipeline                                                       *
 *************************************************************************/
module FpAdd (
    input  logic        iCLK,
    input  logic [26:0] iA,
    input  logic [26:0] iB,
    output logic [26:0] oSum
);

    // Extract fields of A and B.
    logic        A_s;
    logic [7:0]  A_e;
    logic [17:0] A_f;
    logic        B_s;
    logic [7:0]  B_e;
    logic [17:0] B_f;
    logic        A_larger;

    assign A_s = iA[26];
    assign A_e = iA[25:18];
    assign A_f = {1'b1, iA[17:1]};
    assign B_s = iB[26];
    assign B_e = iB[25:18];
    assign B_f = {1'b1, iB[17:1]};

    // Shift fractions of A and B so that they align.
    logic [7:0]  exp_diff_A;
    logic [7:0]  exp_diff_B;
    logic [7:0]  larger_exp;
    logic [36:0] A_f_shifted;
    logic [36:0] B_f_shifted;

    assign exp_diff_A = B_e - A_e; // if B bigger
    assign exp_diff_B = A_e - B_e; // if A bigger

    assign larger_exp = (B_e > A_e) ? B_e : A_e;

    assign A_f_shifted = A_larger              ? {1'b0, A_f, 18'b0} :
                         (exp_diff_A > 8'd35) ? 37'b0 :
                         ({1'b0, A_f, 18'b0} >> exp_diff_A);
    assign B_f_shifted = ~A_larger             ? {1'b0, B_f, 18'b0} :
                         (exp_diff_B > 8'd35) ? 37'b0 :
                         ({1'b0, B_f, 18'b0} >> exp_diff_B);

    // Determine which of A, B is larger.
    assign A_larger =    (A_e > B_e)                   ? 1'b1 :
                         ((A_e == B_e) && (A_f > B_f)) ? 1'b1 :
                         1'b0;

    // Calculate sum or difference of shifted fractions.
    logic [36:0] pre_sum;
    assign pre_sum = ((A_s ^ B_s) &  A_larger) ? A_f_shifted - B_f_shifted :
                     ((A_s ^ B_s) & ~A_larger) ? B_f_shifted - A_f_shifted :
                     A_f_shifted + B_f_shifted;

    // Buffer midway results.
    logic [36:0] buf_pre_sum;
    logic [7:0]  buf_larger_exp;
    logic        buf_A_e_zero;
    logic        buf_B_e_zero;
    logic [26:0] buf_A;
    logic [26:0] buf_B;
    logic        buf_oSum_s;

    always_ff @(posedge iCLK) begin
        buf_pre_sum    <= pre_sum;
        buf_larger_exp <= larger_exp;
        buf_A_e_zero   <= (A_e == 8'b0);
        buf_B_e_zero   <= (B_e == 8'b0);
        buf_A          <= iA;
        buf_B          <= iB;
        buf_oSum_s     <= A_larger ? A_s : B_s;
    end

    // Convert to positive fraction and a sign bit.
    logic [36:0] pre_frac;
    assign pre_frac = buf_pre_sum;

    // Determine output fraction and exponent change with position of first 1.
    logic [17:0] oSum_f;
    logic [7:0]  shft_amt;

    assign shft_amt = pre_frac[36] ? 8'd0  : pre_frac[35] ? 8'd1  :
                      pre_frac[34] ? 8'd2  : pre_frac[33] ? 8'd3  :
                      pre_frac[32] ? 8'd4  : pre_frac[31] ? 8'd5  :
                      pre_frac[30] ? 8'd6  : pre_frac[29] ? 8'd7  :
                      pre_frac[28] ? 8'd8  : pre_frac[27] ? 8'd9  :
                      pre_frac[26] ? 8'd10 : pre_frac[25] ? 8'd11 :
                      pre_frac[24] ? 8'd12 : pre_frac[23] ? 8'd13 :
                      pre_frac[22] ? 8'd14 : pre_frac[21] ? 8'd15 :
                      pre_frac[20] ? 8'd16 : pre_frac[19] ? 8'd17 :
                      pre_frac[18] ? 8'd18 : pre_frac[17] ? 8'd19 :
                      pre_frac[16] ? 8'd20 : pre_frac[15] ? 8'd21 :
                      pre_frac[14] ? 8'd22 : pre_frac[13] ? 8'd23 :
                      pre_frac[12] ? 8'd24 : pre_frac[11] ? 8'd25 :
                      pre_frac[10] ? 8'd26 : pre_frac[9]  ? 8'd27 :
                      pre_frac[8]  ? 8'd28 : pre_frac[7]  ? 8'd29 :
                      pre_frac[6]  ? 8'd30 : pre_frac[5]  ? 8'd31 :
                      pre_frac[4]  ? 8'd32 : pre_frac[3]  ? 8'd33 :
                      pre_frac[2]  ? 8'd34 : pre_frac[1]  ? 8'd35 :
                      pre_frac[0]  ? 8'd36 : 8'd37;

    logic [53:0] pre_frac_shft;
    logic [53:0] uflow_shift;

    // The shift +1 is because high order bit is not stored, but implied.
    assign pre_frac_shft = {pre_frac, 17'b0} << (shft_amt + 8'd1);
    assign uflow_shift   = {pre_frac, 17'b0} << shft_amt;
    assign oSum_f        = pre_frac_shft[53:36];

    logic [7:0] oSum_e;
    assign oSum_e = buf_larger_exp - shft_amt + 8'd1;

    // Detect underflow. If top bit of mantissa is not set, then denormalize
    logic underflow;
    assign underflow = ~uflow_shift[53];

    always_ff @(posedge iCLK) begin
        oSum <= (buf_A_e_zero && buf_B_e_zero) ? 27'b0 :
                buf_A_e_zero                  ? buf_B :
                buf_B_e_zero                  ? buf_A :
                underflow                     ? 27'b0 :
                (pre_frac == 37'b0)           ? 27'b0 :
                {buf_oSum_s, oSum_e, oSum_f};
    end

endmodule
