TheOnlyMiki/CSEE-4840-N-Body/Hardware/code/FpInvSqrt.sv

/**************************************************************************
 * Floating Point Fast Inverse Square Root                                *
 * 5-stage pipeline                                                       *
 * http://en.wikipedia.org/wiki/Fast_inverse_square_root                  *
 * Magic number 27'd49920718                                              *
 * 1.5 = 27'd33423360                                                     *
 *************************************************************************/
module FpInvSqrt (
    input  logic        iCLK,
    input  logic [26:0] iA,
    output logic [26:0] oInvSqrt
);

    // Extract fields of A.
    logic        A_s;
    logic [7:0]  A_e;
    logic [17:0] A_f;

    assign A_s = iA[26];
    assign A_e = iA[25:18];
    assign A_f = iA[17:0];

    // Stage 1.
    logic [26:0] y_1;
    logic [26:0] y_1_out;
    logic [26:0] half_iA_1;

    assign y_1       = 27'd49920718 - (iA >> 1);
    assign half_iA_1 = {A_s, A_e - 8'd1, A_f};

    FpMul s1_mult (
        .iA   (y_1),
        .iB   (y_1),
        .oProd(y_1_out)
    );

    // Stage 2.
    logic [26:0] y_2;
    logic [26:0] mult_2_in;
    logic [26:0] half_iA_2;
    logic [26:0] y_2_out;

    FpMul s2_mult (
        .iA   (half_iA_2),
        .iB   (mult_2_in),
        .oProd(y_2_out)
    );

    // Stage 3.
    logic [26:0] y_3;
    logic [26:0] add_3_in;
    logic [26:0] y_3_out;

    FpAdd s3_add (
        .iCLK(iCLK),
        .iA  ({~add_3_in[26], add_3_in[25:0]}),
        .iB  (27'd33423360),
        .oSum(y_3_out)
    );

    // Stage 4.
    logic [26:0] y_4;

    // Stage 5.
    logic [26:0] y_5;

    FpMul s5_mult (
        .iA   (y_5),
        .iB   (y_3_out),
        .oProd(oInvSqrt)
    );

    always_ff @(posedge iCLK) begin
        // Stage 1 to 2.
        y_2       <= y_1;
        mult_2_in <= y_1_out;
        half_iA_2 <= half_iA_1;

        // Stage 2 to 3.
        y_3      <= y_2;
        add_3_in <= y_2_out;

        // Stage 3 to 4.
        y_4 <= y_3;

        // Stage 4 to 5.
        y_5 <= y_4;
    end

endmodule
