TheOnlyMiki/CSEE-4840-N-Body/(commit log)

2026-04-28 fix local param issue
    [nbody_mem.sv]
2026-04-30 fixed memory to use M10K mem blocks
    [nbody_accel_avmm.sv, nbody_control.sv, nbody_mem.sv]
2026-05-11 fixed two_body_core testbench delay error
    [tb_core_accel.sv]
2026-05-11 small code bug fix
    [framebuffer_ram.sv, nbody_accel_avmm.sv, vga_bitmap_avmm.sv]
2026-05-11 change async resets to synchronous
    [four_core_wrapper.sv, nbody_accel_avmm.sv, nbody_control.sv, nbody_integrator.sv, tb_nbody_control.sv, tb_nbody_integrator.sv, two_body_core.sv, vga_bitmap_avmm.sv]
2026-05-11 full frame test
2026-05-11 fix X Y coord bugs
    [accelerator_driver.c, nbody.h]
2026-05-11 Implement long press for A/D buttons
2026-05-12 Fix bugs for nbody display
    [display.c, main.c, nbody.c, nbody.h]
2026-05-12 fix vga stability by inimizing global routing
    [nbody_control.sv]
